Volkan-Turgut/Wireless-Smart-Glove-Controller-Senior-Design-Project/STM32/main.c

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
/* Includes ------------------------------------------------------------------*/
#include "main.h"

/* USER CODE BEGIN Includes */
#include <stdio.h>
#include "ai_datatypes_defines.h"
#include "glove_model_data.h"
#include "glove_model.h"
#include "stm32f4xx_hal.h"
#include "TJ_MPU6050.h"
/* USER CODE END Includes */

ADC_HandleTypeDef hadc1;

CRC_HandleTypeDef hcrc;

I2C_HandleTypeDef hi2c1;

SPI_HandleTypeDef hspi1;

void SystemClock_Config(void);
static void MX_GPIO_Init(void);
static void MX_ADC1_Init(void);
static void MX_SPI1_Init(void);
static void MX_CRC_Init(void);
static void MX_I2C1_Init(void);

uint32_t getMax(ai_float out_data[]);
void modifyString(uint32_t data, uint8_t flexdata[4]);

/* USER CODE BEGIN PFP */
uint32_t flex_value1;
uint32_t flex_value2;
uint32_t flex_value3;
uint32_t flex_value4;
uint32_t flex_value5;



/* USER CODE END PFP */

/* USER CODE BEGIN 0 */
void ADC_Select_Channel0(void){
	ADC_ChannelConfTypeDef sConfig = {0};
	  sConfig.Channel = ADC_CHANNEL_0;
	  sConfig.Rank = 1;
	  sConfig.SamplingTime = ADC_SAMPLETIME_3CYCLES;
	  if (HAL_ADC_ConfigChannel(&hadc1, &sConfig) != HAL_OK)
	  {
	    Error_Handler();
	  }
}

void ADC_Select_Channel1(void){
	ADC_ChannelConfTypeDef sConfig = {0};

	  sConfig.Channel = ADC_CHANNEL_3;
	  sConfig.Rank = 1;
	  sConfig.SamplingTime = ADC_SAMPLETIME_3CYCLES;
	  if (HAL_ADC_ConfigChannel(&hadc1, &sConfig) != HAL_OK)
	  {
	    Error_Handler();
	  }
}

void ADC_Select_Channel2(void){
	ADC_ChannelConfTypeDef sConfig = {0};

	  sConfig.Channel = ADC_CHANNEL_6;
	  sConfig.Rank = 1;
	  sConfig.SamplingTime = ADC_SAMPLETIME_3CYCLES;
	  if (HAL_ADC_ConfigChannel(&hadc1, &sConfig) != HAL_OK)
	  {
	    Error_Handler();
	  }
}

void ADC_Select_Channel3(void){
	ADC_ChannelConfTypeDef sConfig = {0};

	  sConfig.Channel = ADC_CHANNEL_9;
	  sConfig.Rank = 1;
	  sConfig.SamplingTime = ADC_SAMPLETIME_3CYCLES;
	  if (HAL_ADC_ConfigChannel(&hadc1, &sConfig) != HAL_OK)
	  {
	    Error_Handler();
	  }
}

void ADC_Select_Channel4(void){
	ADC_ChannelConfTypeDef sConfig = {0};

	  sConfig.Channel = ADC_CHANNEL_12;
	  sConfig.Rank = 1;
	  sConfig.SamplingTime = ADC_SAMPLETIME_3CYCLES;
	  if (HAL_ADC_ConfigChannel(&hadc1, &sConfig) != HAL_OK)
	  {
	    Error_Handler();
	  }
}

/* USER CODE END 0 */

/**
  * @brief  The application entry point.
  * @retval int
  */
int main(void)
{
  /* USER CODE BEGIN 1 */
	MPU_ConfigTypeDef myMPUConfig;

	RawData_Def myMPUAccelRaw;
	RawData_Def myMPUGyroRaw;
	ScaledData_Def myMPUAccelScaled;
	ScaledData_Def myMPUGyroScaled;
  /* USER CODE END 1 */

  /* MCU Configuration--------------------------------------------------------*/

  /* Reset of all peripherals, Initializes the Flash interface and the Systick. */
  HAL_Init();

  /* Configure the system clock */
  SystemClock_Config();

  /* Initialize all configured peripherals */
  MX_GPIO_Init();
  MX_ADC1_Init();
  MX_SPI1_Init();
  MX_CRC_Init();
  MX_I2C1_Init();

  MPU6050_Init(&hi2c1);

  myMPUConfig.ClockSource=Internal_8MHz;
  myMPUConfig.Gyro_Full_Scale=FS_SEL_500;
  myMPUConfig.Accel_Full_Scale=AFS_SEL_4g;
  myMPUConfig.CONFIG_DLPF=DLPF_184A_188G_Hz;
  myMPUConfig.Sleep_Mode_Bit=0;
  MPU6050_Config(&myMPUConfig);

  /* USER CODE BEGIN 2 */
  ai_error ai_err;
  ai_i32 nbatch;

  AI_ALIGNED(4) ai_u8 activations[AI_GLOVE_MODEL_DATA_ACTIVATIONS_SIZE];

  AI_ALIGNED(4) ai_float in_data[AI_GLOVE_MODEL_IN_1_SIZE];
  AI_ALIGNED(4) ai_float out_data[AI_GLOVE_MODEL_IN_1_SIZE];

  ai_handle glove_model= AI_HANDLE_NULL;

  ai_buffer ai_input[AI_GLOVE_MODEL_IN_NUM]=AI_GLOVE_MODEL_IN;
  ai_buffer ai_output[AI_GLOVE_MODEL_OUT_NUM]=AI_GLOVE_MODEL_OUT;

  ai_network_params ai_params={
  		  AI_GLOVE_MODEL_DATA_WEIGHTS(ai_glove_model_data_weights_get()),
  		  AI_GLOVE_MODEL_DATA_ACTIVATIONS(activations)
    };
  ai_input[0].n_batches=1;
  ai_input[0].data=AI_HANDLE_PTR(in_data);
  ai_output[0].n_batches=1;
  ai_output[0].data=AI_HANDLE_PTR(out_data);

  ai_err=ai_glove_model_create(&glove_model, AI_GLOVE_MODEL_DATA_CONFIG);
  if(ai_err.type!=AI_ERROR_NONE){
  }

  if(!ai_glove_model_init(glove_model,&ai_params)){
  }

  uint8_t data[4];

  uint32_t result;

  int triggered=0;

  /* USER CODE END 2 */

  /* Infinite loop */
  /* USER CODE BEGIN WHILE */

  while (1)
  {
	  MPU6050_Get_Accel_RawData(&myMPUAccelRaw);
	  MPU6050_Get_Gyro_RawData(&myMPUGyroRaw);

	  MPU6050_Get_Accel_Scale(&myMPUAccelScaled);
	  MPU6050_Get_Gyro_Scale(&myMPUGyroScaled);

	  	  	  	  if(myMPUGyroRaw.x<-10000 && triggered==1){
	  	  	  		  triggered=0;
	  	  	  	  }


	  	  	  	  if(myMPUGyroRaw.x>10000 && triggered==0){

	  	  	  		  	  	  triggered=1;

	  	  	  	  	  	  	  ADC_Select_Channel0();
	  	  	  	  	  	 	  HAL_ADC_Start(&hadc1);
	  	  	  	  	  	 	  HAL_ADC_PollForConversion(&hadc1,1000);
	  	  	  	  	  	 	  flex_value1=HAL_ADC_GetValue(&hadc1);
	  	  	  	  	  	 	  HAL_ADC_Stop(&hadc1);

	  	  	  	  	  	 	  ADC_Select_Channel1();
	  	  	  	  	  	 	  HAL_ADC_Start(&hadc1);
	  	  	  	  	  	 	  HAL_ADC_PollForConversion(&hadc1,1000);
	  	  	  	  	  	 	  flex_value2=HAL_ADC_GetValue(&hadc1);
	  	  	  	  	  	 	  HAL_ADC_Stop(&hadc1);

	  	  	  	  	  	 	  ADC_Select_Channel2();
	  	  	  	  	  	 	  HAL_ADC_Start(&hadc1);
	  	  	  	  	  	 	  HAL_ADC_PollForConversion(&hadc1,1000);
	  	  	  	  	  	 	  flex_value3=HAL_ADC_GetValue(&hadc1);
	  	  	  	  	  	 	  HAL_ADC_Stop(&hadc1);

	  	  	  	  	  	 	  ADC_Select_Channel3();
	  	  	  	  	  	 	  HAL_ADC_Start(&hadc1);
	  	  	  	  	  	 	  HAL_ADC_PollForConversion(&hadc1,1000);
	  	  	  	  	  	 	  flex_value4=HAL_ADC_GetValue(&hadc1);
	  	  	  	  	  	 	  HAL_ADC_Stop(&hadc1);

	  	  	  	  	  	 	  ADC_Select_Channel4();
	  	  	  	  	  	 	  HAL_ADC_Start(&hadc1);
	  	  	  	  	  	 	  HAL_ADC_PollForConversion(&hadc1,1000);
	  	  	  	  	  	 	  flex_value5=HAL_ADC_GetValue(&hadc1);
	  	  	  	  	  	 	  HAL_ADC_Stop(&hadc1);

	  	  	  	  	  	 	  HAL_Delay(2);
	  	  	  	  	  		  ((ai_float *)in_data)[0]=(ai_float)flex_value1;
	  	  	  	  	  		  ((ai_float *)in_data)[1]=(ai_float)flex_value2;
	  	  	  	  	  		  ((ai_float *)in_data)[2]=(ai_float)flex_value3;
	  	  	  	  	  		  ((ai_float *)in_data)[3]=(ai_float)flex_value4;
	  	  	  	  	  		  ((ai_float *)in_data)[4]=(ai_float)flex_value5;

	  	  	  	  	  		  nbatch=ai_glove_model_run(glove_model, &ai_input[0],&ai_output[0]);
	  	  	  	  	  		  if(nbatch!=1){
	  	  	  	  	  		  }

	  	  	  	  	  		  result=getMax(out_data);
	  	  	  	  	  		  modifyString(result,data);
	  	  	  	  	  		  HAL_GPIO_WritePin(GPIOA,GPIO_PIN_4, GPIO_PIN_RESET);
	  	  	  	  	  		  HAL_SPI_Transmit(&hspi1, (uint16_t*)data, 2, 100);
	  	  	  	  	  		  HAL_Delay(2);
	  	  	  	  	  		  HAL_GPIO_WritePin(GPIOA,GPIO_PIN_4, GPIO_PIN_SET);

    /* USER CODE END WHILE */

    /* USER CODE BEGIN 3 */
  }
  /* USER CODE END 3 */
}

}

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
/* USER CODE BEGIN 4 */
void modifyString(uint32_t data, uint8_t flexdata[4]){

	sprintf(flexdata, "%d",data);
	char first=flexdata[1];
	char second=flexdata[0];
	flexdata[0]=first;
	flexdata[1]=second;
	first=flexdata[3];
	second=flexdata[2];
	flexdata[2]=first;
	flexdata[3]=second;
}


uint32_t getMax(ai_float out_data[]){
	ai_float max=out_data[0];
	int max_index=0;
	for(int i=1; i<5;i++){
		if(out_data[i]>max){
			max=out_data[i];
			max_index=i;
		}
	}
	max_index++;
	if(max<0.95){
		max_index=9;
	}
	return (uint32_t) max_index;
}
/* USER CODE END 4 */
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
