Volkan-Turgut/Wireless-Smart-Glove-Controller-Senior-Design-Project/STM32/sifirdan_komple.ioc

Mcu.UserName=STM32F429ZITx
PA0/WKUP.Signal=ADCx_IN0
PA10.Signal=GPIO_Input
PA3.Signal=ADCx_IN3
PA4.Signal=GPIO_Output
PA5.Signal=SPI1_SCK
PA6.Signal=ADCx_IN6
PA7.Signal=SPI1_MOSI
PB1.Signal=ADCx_IN9
PB4.Signal=SPI1_MISO
PB6.Signal=I2C1_SCL
PB7.Signal=I2C1_SDA
PC2.Signal=ADCx_IN12
PD5.Signal=GPXTI5
PG13.Signal=GPIO_Output
PH0/OSC_IN.Signal=RCC_OSC_IN
PH1/OSC_OUT.Signal=RCC_OSC_OUT
