Volkan-Turgut/Wireless-Smart-Glove-Controller-Senior-Design-Project/ESP32/main.c

#include <stdio.h>
#include "freertos/FreeRTOS.h"
#include "freertos/task.h"
#include "freertos/queue.h"
#include "driver/gpio.h"



#include <stdio.h>
#include <esp_system.h>
#include <stdio.h>
#include <stdint.h>
#include <stddef.h>
#include <string.h>

#include "freertos/FreeRTOS.h"
#include "freertos/task.h"
#include "freertos/semphr.h"
#include "freertos/queue.h"

#include "lwip/sockets.h"
#include "lwip/dns.h"
#include "lwip/netdb.h"
#include "lwip/igmp.h"

#include "esp_wifi.h"
#include "esp_system.h"
#include "esp_event.h"
#include "nvs_flash.h"
#include "soc/rtc_periph.h"
#include "driver/spi_slave.h"
#include "esp_log.h"
#include "spi_flash_mmap.h"
#include "driver/gpio.h"
#include "esp_netif.h"
#include "mqtt_client.h"


#include <stdio.h>
#include <stdint.h>
#include <stddef.h>
#include <string.h>
#include "esp_wifi.h"
#include "esp_system.h"
#include "nvs_flash.h"
#include "esp_event.h"
#include "esp_netif.h"

#include "freertos/FreeRTOS.h"
#include "freertos/task.h"
#include "freertos/semphr.h"
#include "freertos/queue.h"

#include "lwip/sockets.h"
#include "lwip/dns.h"
#include "lwip/netdb.h"

#include "esp_log.h"
#include "mqtt_client.h"

#define INPUT_PIN 12
#define LED_PIN 26

#define GPIO_MOSI 23
#define GPIO_MISO 19
#define GPIO_SCLK 18
#define GPIO_CS 5

static const char *TAG = "MQTT_TCP";

int state = 0;
QueueHandle_t interputQueue;
static void wifi_event_handler(void *event_handler_arg, esp_event_base_t event_base, int32_t event_id, void *event_data)
{
    switch (event_id)
    {
    case WIFI_EVENT_STA_START:
        printf("WiFi connecting ... \n");
        break;
    case WIFI_EVENT_STA_CONNECTED:
        printf("WiFi connected ... \n");
        break;
    case WIFI_EVENT_STA_DISCONNECTED:
        printf("WiFi lost connection ... \n");
        break;
    case IP_EVENT_STA_GOT_IP:
        printf("WiFi got IP ... \n\n");
        break;
    default:
        break;
    }
}

void wifi_connection()
{
    // 1 - Wi-Fi/LwIP Init Phase
    esp_netif_init();                    // TCP/IP initiation 					s1.1
    esp_event_loop_create_default();     // event loop 			                s1.2
    esp_netif_create_default_wifi_sta(); // WiFi station 	                    s1.3
    wifi_init_config_t wifi_initiation = WIFI_INIT_CONFIG_DEFAULT();
    esp_wifi_init(&wifi_initiation); // 					                    s1.4
    // 2 - Wi-Fi Configuration Phase
    esp_event_handler_register(WIFI_EVENT, ESP_EVENT_ANY_ID, wifi_event_handler, NULL);
    esp_event_handler_register(IP_EVENT, IP_EVENT_STA_GOT_IP, wifi_event_handler, NULL);
    wifi_config_t wifi_configuration = {
        .sta = {
            .ssid = "volkanpc",
            .password = "12345678"}};
    esp_wifi_set_config(ESP_IF_WIFI_STA, &wifi_configuration);
    // 3 - Wi-Fi Start Phase
    esp_wifi_start();
    // 4- Wi-Fi Connect Phase
    esp_wifi_connect();
}

static esp_err_t mqtt_event_handler_cb(esp_mqtt_event_handle_t event)
{
    esp_mqtt_client_handle_t client = event->client;
    switch (event->event_id)
    {
    case MQTT_EVENT_CONNECTED:
        ESP_LOGI(TAG, "MQTT_EVENT_CONNECTED");
        esp_mqtt_client_subscribe(client, "my_topic", 0);
        break;
    case MQTT_EVENT_DISCONNECTED:
        ESP_LOGI(TAG, "MQTT_EVENT_DISCONNECTED");
        break;
    case MQTT_EVENT_SUBSCRIBED:
        ESP_LOGI(TAG, "MQTT_EVENT_SUBSCRIBED, msg_id=%d", event->msg_id);
        break;
    case MQTT_EVENT_UNSUBSCRIBED:
        ESP_LOGI(TAG, "MQTT_EVENT_UNSUBSCRIBED, msg_id=%d", event->msg_id);
        break;
    case MQTT_EVENT_PUBLISHED:
        ESP_LOGI(TAG, "MQTT_EVENT_PUBLISHED, msg_id=%d", event->msg_id);
        break;
    case MQTT_EVENT_DATA:
        ESP_LOGI(TAG, "MQTT_EVENT_DATA");
        printf("\nTOPIC=%.*s\r\n", event->topic_len, event->topic);
        printf("DATA=%.*s\r\n", event->data_len, event->data);
        break;
    case MQTT_EVENT_ERROR:
        ESP_LOGI(TAG, "MQTT_EVENT_ERROR");
        break;
    default:
        ESP_LOGI(TAG, "Other event id:%d", event->event_id);
        break;
    }
    return ESP_OK;
}

static void mqtt_event_handler(void *handler_args, esp_event_base_t base, int32_t event_id, void *event_data)
{
    ESP_LOGD(TAG, "Event dispatched from event loop base=%s, event_id=%lu", base, event_id);
    mqtt_event_handler_cb(event_data);
}


static void IRAM_ATTR gpio_interrupt_handler(void *args)
{
    int pinNumber = (int)args;
    xQueueSendFromISR(interputQueue, &pinNumber, NULL);
}

void LED_Control_Task(void *params)
{
    int pinNumber, count = 0;
    while (true)
    {
        if (xQueueReceive(interputQueue, &pinNumber, portMAX_DELAY))
        {
            gpio_set_level(LED_PIN, gpio_get_level(INPUT_PIN));
        }
    }
}

void app_main()
{
    nvs_flash_init();
    wifi_connection();

    vTaskDelay(2000 / portTICK_PERIOD_MS);
    printf("WIFI was initiated ...........\n");

    esp_mqtt_client_config_t mqtt_cfg = {
        .broker.address.uri = "mqtt://192.168.137.1",
    };
    esp_mqtt_client_handle_t client = esp_mqtt_client_init(&mqtt_cfg);
    esp_mqtt_client_register_event(client, ESP_EVENT_ANY_ID, mqtt_event_handler, client);
    esp_mqtt_client_start(client);
	spi_bus_config_t buscfg={
        .mosi_io_num=GPIO_MOSI,
        .miso_io_num=GPIO_MISO,
        .sclk_io_num=GPIO_SCLK,
        .quadwp_io_num = -1,
        .quadhd_io_num = -1,
    };

    //Configuration for the SPI slave interface
    spi_slave_interface_config_t slvcfg={
        .mode=0,
        .spics_io_num=GPIO_CS,
        .queue_size=8,
        .flags=0,
    };

    //Initialize SPI slave interface
    spi_slave_initialize(VSPI_HOST, &buscfg, &slvcfg, SPI_DMA_CH_AUTO);

    char recvbuf[129]="";
    memset(recvbuf, 0, 33);
    spi_slave_transaction_t t;
    memset(&t, 0, sizeof(t));



	esp_rom_gpio_pad_select_gpio(LED_PIN);
    gpio_set_direction(LED_PIN, GPIO_MODE_OUTPUT);

    esp_rom_gpio_pad_select_gpio(INPUT_PIN);
    gpio_set_direction(INPUT_PIN, GPIO_MODE_INPUT);
    gpio_pulldown_en(INPUT_PIN);
    gpio_pullup_dis(INPUT_PIN);
    gpio_set_intr_type(INPUT_PIN, GPIO_INTR_POSEDGE);

    interputQueue = xQueueCreate(10, sizeof(int));
    xTaskCreate(LED_Control_Task, "LED_Control_Task", 2048, NULL, 1, NULL);

    gpio_install_isr_service(0);
    gpio_isr_handler_add(INPUT_PIN, gpio_interrupt_handler, (void *)INPUT_PIN);





    while(true){
//    	int i=0;
//    	while(i<5){
        t.length=128*8;
        t.rx_buffer=recvbuf;
        spi_slave_transmit(VSPI_HOST, &t, portMAX_DELAY);
        if(recvbuf!=NULL){
		printf("komut: %s\n", recvbuf);
        esp_mqtt_client_publish(client, "my_topic", recvbuf, 0, 1, 0);

        }

        //sonradan eklenilen ve silinmesi gereken
//        	switch(i){
//        	case 0:
//        		printf("yuzuk: %s\n", recvbuf);
//        		break;
//
//           	case 1:
//            		printf("orta: %s\n", recvbuf);
//            		break;
//
//
//           	case 2:
//            		printf("isaret: %s\n", recvbuf);
//            		break;
//
//
//           	case 3:
//            		printf("bas: %s\n", recvbuf);
//            		break;
//
//
//           	case 4:
//            		printf("serce: %s\n", recvbuf);
//            		break;
//
//
//        	}
//        	i++;
//        }
//    	printf("\n");
    }
}
