Volkan-Turgut/Wireless-Smart-Glove-Controller-Senior-Design-Project/(commit log)

2023-11-12 Update and rename mqtt_new_main.c to esp32_main.c
2023-11-12 Update and rename final_dataset_excel.csv to final_dataset.csv
    [final_dataset.csv]
2023-11-12 Create STM32
