Volkan-Turgut/Wireless-Smart-Glove-Controller-Senior-Design-Project/(notices)

Notices in the files:
STM32/main.c:
Copyright (c) 2023 STMicroelectronics.
All rights reserved.
This software is licensed under terms that can be found in the LICENSE file
